idcrook/attiny85_tiny_function_generator/eagle_sch/attiny85_LCD_rotaryenc_w_btn.sch

## EAGLE design eagle_sch/attiny85_LCD_rotaryenc_w_btn.sch (2018-03-10)

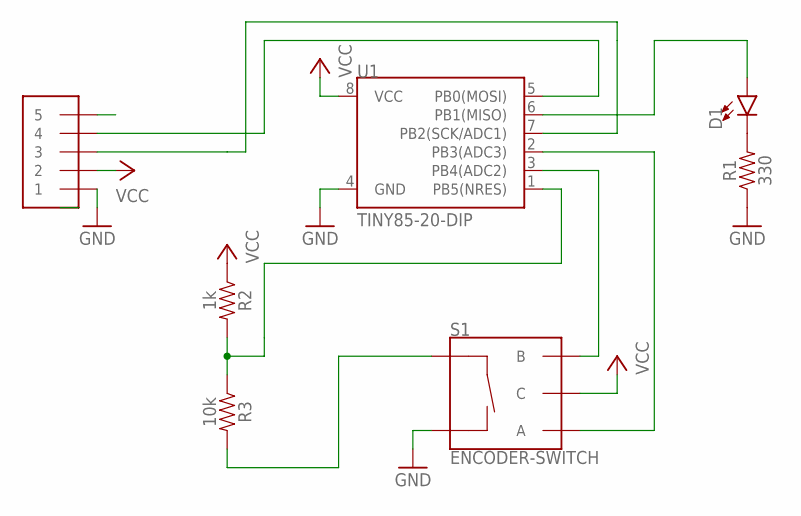
[picture p8: schematic attiny85_LCD_rotaryenc_w_btn.sch]

Parts:
D1: LED3MM; LED_3MM
J1: 1X5; 3.5MM-5P
R1: 330; AXIAL-0.3
R2: 1k; AXIAL-0.3
R3: 10k; AXIAL-0.3
S1: ENCODER-SWITCH; ROTARY_ENC_PLAIN
U1: TINY85-20-DIP; DIP08_MCU

Connections:
GND: J1.1, R1.P$1 (1), S1.SW-, U1.4 (GND)
unnamed: J1.3, U1.7 (PB2(SCK/ADC1))
unnamed: J1.4, U1.5 (PB0(MOSI))
unnamed: D1.K (C), R1.P$2 (2)
unnamed: D1.A, U1.6 (PB1(MISO))
unnamed: S1.A, U1.2 (PB3(ADC3))
unnamed: S1.B, U1.3 (PB4(ADC2))
unnamed: R3.P$2 (2), S1.SW+
unnamed: R2.P$2 (2), R3.P$1 (1), U1.1 (PB5(NRES))
VCC: J1.2, R2.P$1 (1), S1.C, U1.8 (VCC)
