idcrook/attiny85_tiny_function_generator/eagle_sch/attiny85_arduino_as_ISP_programmer.sch

## EAGLE design eagle_sch/attiny85_arduino_as_ISP_programmer.sch (2018-03-10)

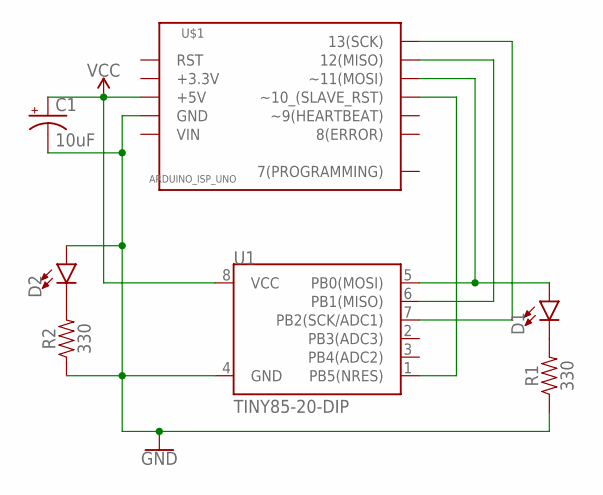
[picture p9: schematic attiny85_arduino_as_ISP_programmer.sch]

Parts:
C1: 10uF; CPOL-RADIAL-2.5MM-5MM
D1, D2: LED3MM; LED_3MM
R1, R2: 330; AXIAL-0.3
U1: TINY85-20-DIP; DIP08_MCU
U$1: ARDUINO_ISP_UNO; ARDUINO_UNO_ISP

Connections:
GND: C1.2 (-), D2.A, R1.P$1 (1), R2.P$1 (1), U1.4 (GND), U$1.GND@1 (GND)
unnamed: D1.K (C), R1.P$2 (2)
unnamed: D2.K (C), R2.P$2 (2)
unnamed: U1.7 (PB2(SCK/ADC1)), U$1.D13 (13(SCK))
unnamed: U1.6 (PB1(MISO)), U$1.D12 (12(MISO))
unnamed: D1.A, U1.5 (PB0(MOSI)), U$1.D11 (~11(MOSI))
unnamed: U1.1 (PB5(NRES)), U$1.D10 (~10_(SLAVE_RST))
VCC: C1.1 (+), U1.8 (VCC), U$1.5V (+5V)
