idcrook/attiny85_tiny_function_generator/eagle_sch/attiny85_i2c_lcd_display.sch

## EAGLE design eagle_sch/attiny85_i2c_lcd_display.sch (2018-03-10)

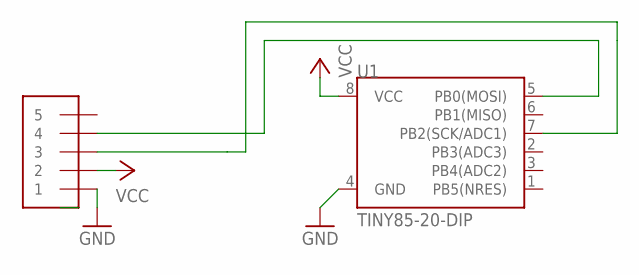
[picture p10: schematic attiny85_i2c_lcd_display.sch]

Parts:
J1: 1X5; 3.5MM-5P
U1: TINY85-20-DIP; DIP08_MCU

Connections:
GND: J1.1, U1.4 (GND)
unnamed: J1.3, U1.7 (PB2(SCK/ADC1))
unnamed: J1.4, U1.5 (PB0(MOSI))
VCC: J1.2, U1.8 (VCC)
