idcrook/attiny85_tiny_function_generator/eagle_sch/tiny_function_generator_w_output_filter.sch

## EAGLE design eagle_sch/tiny_function_generator_w_output_filter.sch (2018-03-10)

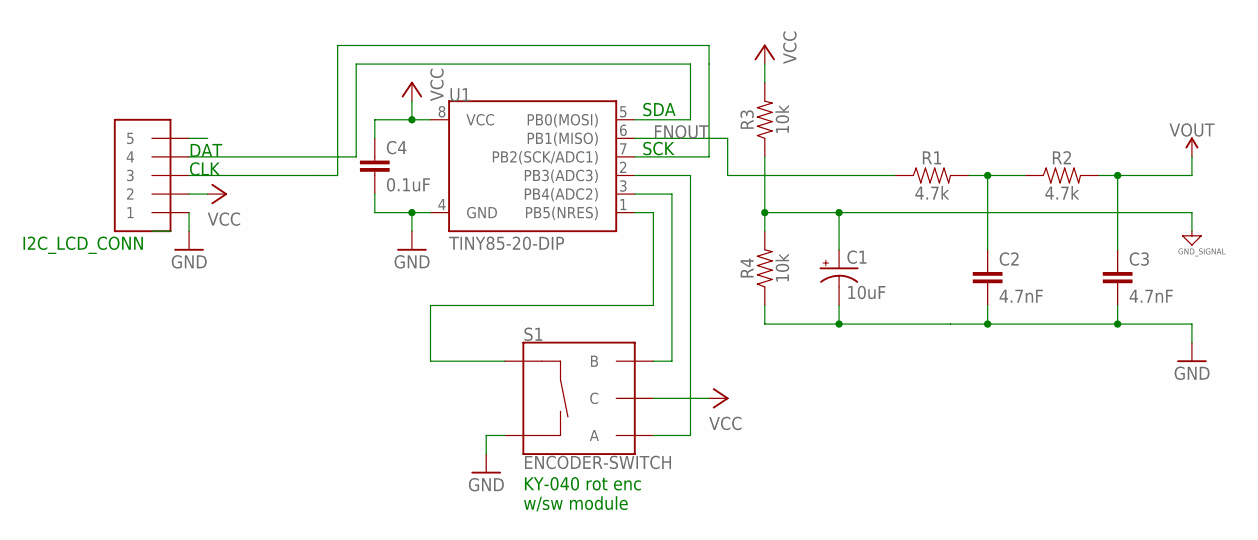
[picture p11: schematic tiny_function_generator_w_output_filter.sch]

Parts:
C1: 10uF; CPOL-RADIAL-2.5MM-5MM
C2, C3: 4.7nF; 0603
C4: 0.1uF; CAP-PTH-SMALL-KIT
J1: 1X5; 3.5MM-5P
R1, R2: 4.7k; 0603
R3, R4: 10k; AXIAL-0.3
S1: ENCODER-SWITCH; ROTARY_ENC_PLAIN
U1: TINY85-20-DIP; DIP08_MCU

Connections:
AGND: C1.1 (+), R3.P$1 (1), R4.P$2 (2)
FNOUT: R1.1, U1.6 (PB1(MISO))
GND: C1.2 (-), C2.2, C3.2, C4.2, J1.1, R4.P$1 (1), S1.SW-, U1.4 (GND)
unnamed: J1.3, U1.7 (PB2(SCK/ADC1))
unnamed: J1.4, U1.5 (PB0(MOSI))
unnamed: C2.1, R1.2, R2.1
unnamed: S1.A, U1.2 (PB3(ADC3))
unnamed: S1.B, U1.3 (PB4(ADC2))
unnamed: S1.SW+, U1.1 (PB5(NRES))
VCC: C4.1, J1.2, R3.P$2 (2), S1.C, U1.8 (VCC)
VOUT: C3.1, R2.2

Notes on the sheet:
I2C_LCD_CONN
KY-040 rot enc w/sw module
DAT
CLK
SDA
SCK
