idcrook/attiny85_tiny_function_generator/(commit log)

2018-03-10 Major first edition
    - added EAGLE-based schematics and Arduino code
    - Added to README images and also description of phases, intermediate projects steps
    [attiny85_LCD_rotaryenc_w_btn.sch, attiny85_arduino_as_ISP_programmer.sch, attiny85_i2c_lcd_display.sch, tiny_function_generator_w_output_filter.sch]
2018-03-10 fixed "chainsaw" icon and tweaked "noise" icon
    [tiny_f_gen_sine_wave_3.ino]
